lauragabrielaneaga/P1/P1_2021_433C_Neaga_Laura-Gabriela_SERS_N16_OrCAD/schema_bloc.jpg

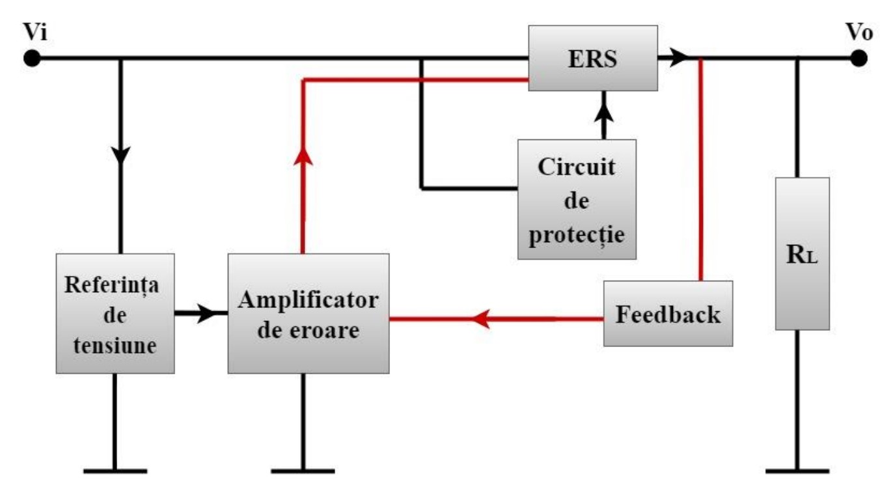
P1_2021_433C_Neaga_Laura-Gabriela_SERS_N16_OrCAD/schema_bloc.jpg
