lauragabrielaneaga/P1/P1_2021_433C_Neaga_Laura-Gabriela_SERS_N16_OrCAD/Schematics/Schema_transfer_OrCAD_PCB.jpg

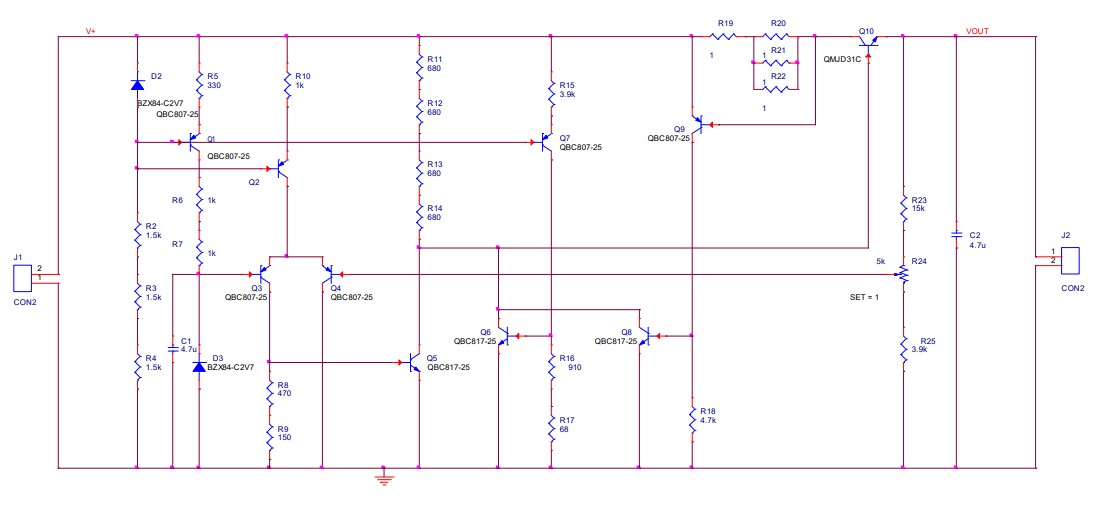
P1_2021_433C_Neaga_Laura-Gabriela_SERS_N16_OrCAD/Schematics/Schema_transfer_OrCAD_PCB.jpg
