lauragabrielaneaga/P1/P1_2021_433C_Neaga_Laura-Gabriela_SERS_N16_OrCAD/Simulations/Amplificarea in bucla deschisa a amplificatorului de eroare.jpg

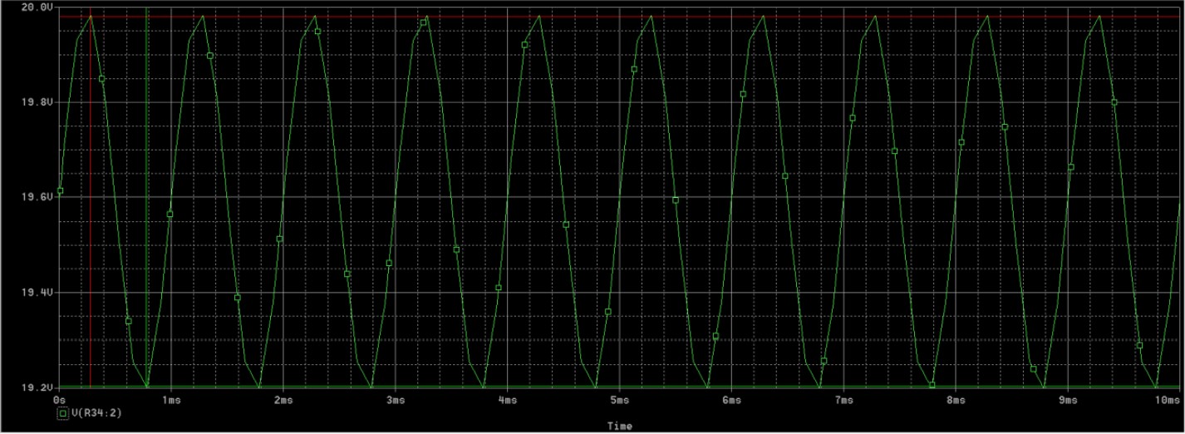
P1_2021_433C_Neaga_Laura-Gabriela_SERS_N16_OrCAD/Simulations/Amplificarea in bucla deschisa a amplificatorului de eroare.jpg
