lauragabrielaneaga/P1/P1_2021_433C_Neaga_Laura-Gabriela_SERS_N16_OrCAD/Simulations/Protectie termica_caz1.jpg

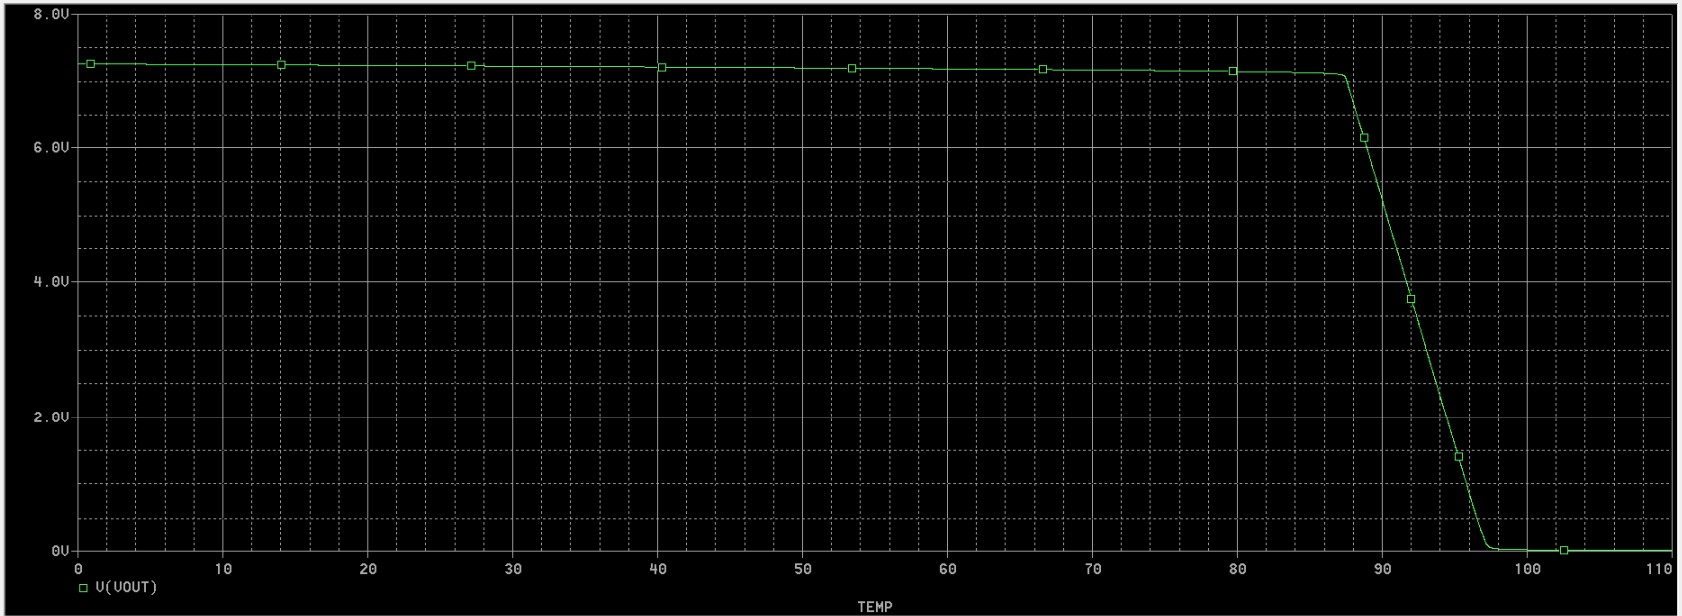
P1_2021_433C_Neaga_Laura-Gabriela_SERS_N16_OrCAD/Simulations/Protectie termica_caz1.jpg
