lauragabrielaneaga/P1/P1_2021_433C_Neaga_Laura-Gabriela_SERS_N16_OrCAD/Bill_of_Materials/BOM_Anexa_a1_Neaga_Laura-Gabriela.xlsx

Anexa a1 - Componente SMD disponibile pentru realizarea proiectului P1 - tehnologie SMT- AU 2021-2022
Nr. Crt. | Nume | Catalog | Cod distrib | Nume prod | Prod | Clasă | Qty fix | Qty final | Qty min | Descriere | Distribuitor | Pret (fara TVA) referinta/buc. TME România | Pret total pe reper (fara TVA) - propus | Pret total pe reper final (fara TVA) - necesar cerut de studenti | Pret total pe reper final (fara TVA)
1 | 0 ohm | (LINK) (http://www.tme.eu/ro/details/smd1206-0r/rezistente-smd-1206/royal-ohm/1206s4j0000t5e/) | 1206S4J0000T5E | 1206S4J0000T5E | SR PASSIVES | rezistor | 0 | 0 | 0 | Rezistor: thick film; SMD; 1206; 0Ω; 0,25W; ±5%; -55÷125°C | TME România | 0.03841 | 0 | 0 | 0 | indisponibil
2 | 0.47 | (LINK) (https://www.tme.eu/ro/details/0805s8j047kt5e/rezistente-smd-0805/royal-ohm/) | 0805S8J047KT5E | 0805S8J047KT5E | ROYAL OHM | rezistor | 0 | 0 | 0 | Rezistor: thick film; SMD; 0805; 470mΩ; 125mW; ±5%; -55÷125°C; 800ppm/°C | TME România | 0.02319 | 0 | 0 | 0
3 | 1 | (LINK) (https://www.tme.eu/ro/details/smd0805-1r/rezistente-smd-0805/royal-ohm/0805s8j010jt5e/) | SMD0805-1R | 0805S8J010JT5E | ROYAL OHM | rezistor | 0 | 0 | 4 | Rezistor: thick film; SMD; 0805; 1Ω; 0,125W; ±5%; -55÷125°C | TME România | 0.01624 | 0 | 0.06496
4 | 4.7 | (LINK) (https://www.tme.eu/ro/details/smd0805-4r7/rezistente-smd-0805/royal-ohm/0805s8j047jt5e/) | SMD0805-4R7 | 0805S8J047JT5E | ROYAL OHM | rezistor | 0 | 0 | 0 | Rezistor: thick film; SMD; 0805; 4,7Ω; 0,125W; ±5%; -55÷125°C | TME România | 0.01624 | 0 | 0 | 0
5 | 10 | (LINK) (https://www.tme.eu/ro/details/smd0805-10r/rezistente-smd-0805/royal-ohm/0805s8j0100t5e/) | SMD0805-10R | 0805S8J0100T5E | ROYAL OHM | rezistor | 0 | 0 | 0 | Rezistor: thick film; SMD; 0805; 10Ω; 0,125W; ±5%; -55÷125°C | TME România | 0.01419 | 0 | 0 | 0
6 | 22 | (LINK) (https://www.tme.eu/ro/details/smd0805-22r-1%25/rezistente-smd-0805/royal-ohm/0805s8f220jt5e/) | SMD0805-22R-1% | 0805S8F220JT5E | ROYAL OHM | rezistor | 0 | 0 | 0 | Rezistor: thick film; SMD; 0805; 22Ω; 0,125W; ±1%; -55÷125°C | TME România | 0.01971 | 0 | 0 | 0
7 | 33 | (LINK) (https://www.tme.eu/ro/details/smd0805-33r/rezistente-smd-0805/royal-ohm/0805s8j0330t5e/) | SMD0805-33R | 0805S8J0330T5E | ROYAL OHM | rezistor | 0 | 0 | 0 | Rezistor: thick film; SMD; 0805; 33Ω; 0,125W; ±5%; -55÷125°C | TME România | 0.01624 | 0 | 0 | 0
8 | 51 | (LINK) (https://www.tme.eu/ro/details/0805s8j0510t5e/rezistente-smd-0805/royal-ohm/) | 0805S8J0510T5E | 0805S8J0510T5E | ROYAL OHM | rezistor | 0 | 0 | 0 | Rezistor: thick film; SMD; 0805; 51Ω; 0,125W; ±5%; -55÷155°C; 200ppm/°C | TME România | 0.00515 | 0 | 0 | 0
9 | 68 | (LINK) (https://www.tme.eu/ro/details/smd0805-68r/rezistente-smd-0805/royal-ohm/0805s8j0680t5e/) | SMD0805-68R | 0805S8J0680T5E | ROYAL OHM | rezistor | 0 | 0 | 1 | Rezistor: thick film; SMD; 0805; 68Ω; 0,125W; ±5%; -55÷125°C | TME România | 0.01624 | 0 | 0.01624 | 0
10 | 82 | (LINK) (https://www.tme.eu/ro/details/smd0805-82r/rezistente-smd-0805/royal-ohm/0805s8j0820t5e/) | SMD0805-82R | 0805S8J0820T5E | ROYAL OHM | rezistor | 0 | 0 | 0 | Rezistor: thick film; SMD; 0805; 82Ω; 0,125W; ±5%; -55÷125°C | TME România | 0.01624 | 0 | 0 | 0
11 | 100 | (LINK) (https://www.tme.eu/ro/details/smd0805-100r/rezistente-smd-0805/royal-ohm/0805s8j0101t5e/) | SMD0805-100R | 0805S8J0101T5E | ROYAL OHM | rezistor | 0 | 0 | 0 | Rezistor: thick film; SMD; 0805; 100Ω; 0,125W; ±5%; -55÷125°C | TME România | 0.01092 | 0 | 0 | 0
12 | 150 | (LINK) (https://www.tme.eu/ro/details/smd0805-150r/rezistente-smd-0805/royal-ohm/0805s8j0151t5e/) | SMD0805-150R | 0805S8J0151T5E | ROYAL OHM | rezistor | 0 | 0 | 1 | Rezistor: thick film; SMD; 0805; 150Ω; 0,125W; ±5%; -55÷125°C | TME România | 0.01624 | 0 | 0.01624 | 0
13 | 220 | (LINK) (https://www.tme.eu/ro/details/smd0805-220r/rezistente-smd-0805/royal-ohm/0805s8j0221t5e/) | SMD0805-220R | 0805S8J0221T5E | ROYAL OHM | rezistor | 0 | 0 | 0 | Rezistor: thick film; SMD; 0805; 220Ω; 0,125W; ±5%; -55÷125°C | TME România | 0.01415 | 0 | 0 | 0
14 | 330 | (LINK) (https://www.tme.eu/ro/details/smd0805-330r/rezistente-smd-0805/royal-ohm/0805s8j0331t5e/) | SMD0805-330R | 0805S8J0331T5E | ROYAL OHM | rezistor | 0 | 0 | 1 | Rezistor: thick film; SMD; 0805; 330Ω; 0,125W; ±5%; -55÷125°C | TME România | 0.01624 | 0 | 0.01624 | 0
15 | 470 | (LINK) (https://www.tme.eu/ro/details/smd0805-470r/rezistente-smd-0805/royal-ohm/0805s8j0471t5e/) | SMD0805-470R | 0805S8J0471T5E | ROYAL OHM | rezistor | 0 | 0 | 1 | Rezistor: thick film; SMD; 0805; 470Ω; 0,125W; ±5%; -55÷125°C | TME România | 0.01415 | 0 | 0.01415 | 0
16 | 510 | (LINK) (https://www.tme.eu/ro/details/smd0805-510r/rezistente-smd-0805/royal-ohm/0805s8j0511t5e/) | SMD0805-510R | 0805S8J0511T5E | ROYAL OHM | rezistor | 0 | 0 | 0 | Rezistor: thick film; SMD; 0805; 510Ω; 0,125W; ±5%; -55÷125°C | TME România | 0.01771 | 0 | 0 | 0
17 | 680 | (LINK) (https://www.tme.eu/ro/details/smd0805-680r/rezistente-smd-0805/royal-ohm/0805s8j0681t5e/) | SMD0805-680R | 0805S8J0681T5E | ROYAL OHM | rezistor | 0 | 0 | 4 | Rezistor: thick film; SMD; 0805; 680Ω; 0,125W; ±5%; -55÷125°C | TME România | 0.01624 | 0 | 0.06496 | 0
18 | 820 | (LINK) (https://www.tme.eu/ro/details/smd0805-820r/rezistente-smd-0805/royal-ohm/0805s8j0821t5e/) | SMD0805-820R | 0805S8J0821T5E | ROYAL OHM | rezistor | 0 | 0 | 0 | Rezistor: thick film; SMD; 0805; 820Ω; 0,125W; ±5%; -55÷125°C | TME România | 0.01624 | 0 | 0 | 0
19 | 910 | (LINK) (https://www.tme.eu/ro/details/smd0805-910r/rezistente-smd-0805/royal-ohm/0805s8j0911t5e/) | SMD0805-910R | 0805S8J0911T5E | ROYAL OHM | rezistor | 0 | 0 | 1 | Rezistor: thick film; SMD; 0805; 910Ω; 0,125W; ±5%; -55÷125°C | TME România | 0.01624 | 0 | 0.01624 | 0
20 | 1k | (LINK) (https://www.tme.eu/ro/details/smd0805-1k/rezistente-smd-0805/royal-ohm/0805s8j0102t5e/) | SMD0805-1K | 0805S8J0102T5E | ROYAL OHM | rezistor | 0 | 0 | 3 | Rezistor: thick film; SMD; 0805; 1kΩ; 0,125W; ±5%; -55÷125°C | TME România | 0.01301 | 0 | 0.03903 | 0
21 | 1.5k | (LINK) (https://www.tme.eu/ro/details/smd0805-1k5/rezistente-smd-0805/royal-ohm/0805s8j0152t5e/) | SMD0805-1K5 | 0805S8J0152T5E | ROYAL OHM | rezistor | 0 | 0 | 3 | Rezistor: thick film; SMD; 0805; 1,5kΩ; 0,125W; ±5%; -55÷125°C | TME România | 0.01624 | 0 | 0.04872 | 0
22 | 1.8k | (LINK) (https://www.tme.eu/ro/details/smd0805-1k8/rezistente-smd-0805/royal-ohm/0805s8j0182t5e/) | SMD0805-1K8 | 0805S8J0182T5E | ROYAL OHM | rezistor | 0 | 0 | 0 | Rezistor: thick film; SMD; 0805; 1,8kΩ; 0,125W; ±5%; -55÷125°C | TME România | 0.01624 | 0 | 0 | 0
23 | 2k | (LINK) (https://www.tme.eu/ro/details/smd0805-2k/rezistente-smd-0805/royal-ohm/0805s8j0202t5e/) | SMD0805-2K | 0805S8J0202T5E | ROYAL OHM | rezistor | 0 | 0 | 0 | Rezistor: thick film; SMD; 0805; 2kΩ; 0,125W; ±5%; -55÷125°C | TME România | 0.01624 | 0 | 0 | 0
24 | 2.2k | (LINK) (https://www.tme.eu/ro/details/smd0805-2k2/rezistente-smd-0805/royal-ohm/0805s8j0222t5e/) | SMD0805-2K2 | 0805S8J0222T5E | ROYAL OHM | rezistor | 0 | 0 | 0 | Rezistor: thick film; SMD; 0805; 2,2kΩ; 0,125W; ±5%; -55÷125°C | TME România | 0.01415 | 0 | 0 | 0
25 | 2.7k | (LINK) (https://www.tme.eu/ro/details/smd0805-2k7/rezistente-smd-0805/royal-ohm/0805s8j0272t5e/) | SMD0805-2K7 | 0805S8J0272T5E | ROYAL OHM | rezistor | 0 | 0 | 0 | Rezistor: thick film; SMD; 0805; 2,7kΩ; 0,125W; ±5%; -55÷125°C | TME România | 0.01624 | 0 | 0 | 0
26 | 3.3k | (LINK) (https://www.tme.eu/ro/details/smd0805-3k3/rezistente-smd-0805/royal-ohm/0805s8j0332t5e/) | SMD0805-3K3 | 0805S8J0332T5E | ROYAL OHM | rezistor | 0 | 0 | 0 | Rezistor: thick film; SMD; 0805; 3,3kΩ; 0,125W; ±5%; -55÷125°C | TME România | 0.01624 | 0 | 0 | 0
27 | 3.9k | (LINK) (https://www.tme.eu/ro/details/smd0805-3k9/rezistente-smd-0805/royal-ohm/0805s8j0392t5e/) | SMD0805-3K9 | 0805S8J0392T5E | ROYAL OHM | rezistor | 0 | 0 | 2 | Rezistor: thick film; SMD; 0805; 3,9kΩ; 0,125W; ±5%; -55÷125°C | TME România | 0.01624 | 0 | 0.03248 | 0
28 | 4.7k | (LINK) (https://www.tme.eu/ro/details/smd0805-4k7/rezistente-smd-0805/royal-ohm/0805s8j0472t5e/) | SMD0805-4K7 | 0805S8J0472T5E | ROYAL OHM | rezistor | 0 | 0 | 1 | Rezistor: thick film; SMD; 0805; 4,7kΩ; 0,125W; ±5%; -55÷125°C | TME România | 0.01215 | 0 | 0.01215 | 0
29 | 5.6k | (LINK) (https://www.tme.eu/ro/details/smd0805-5k6/rezistente-smd-0805/royal-ohm/0805s8j0562t5e/) | SMD0805-5K6 | 0805S8J0562T5E | ROYAL OHM | rezistor | 0 | 0 | 0 | Rezistor: thick film; SMD; 0805; 5,6kΩ; 0,125W; ±5%; -55÷125°C | TME România | 0.01624 | 0 | 0 | 0
30 | 6.8k | (LINK) (https://www.tme.eu/ro/details/smd0805-6k8-1%25/rezistente-smd-0805/royal-ohm/0805s8f6801t5e/) | SMD0805-6K8-1% | 0805S8F6801T5E | ROYAL OHM | rezistor | 0 | 0 | 0 | Rezistor: thick film; SMD; 0805; 6,8kΩ; 0,125W; ±1%; -55÷125°C | TME România | 0.01971 | 0 | 0 | 0
31 | 8.2k | (LINK) (https://www.tme.eu/ro/details/smd0805-8k2/rezistente-smd-0805/royal-ohm/0805s8j0822t5e/) | SMD0805-8K2 | 0805S8J0822T5E | ROYAL OHM | rezistor | 0 | 0 | 0 | Rezistor: thick film; SMD; 0805; 8,2kΩ; 0,125W; ±5%; -55÷125°C | TME România | 0.01624 | 0 | 0 | 0
32 | 9.1k | (LINK) (https://www.tme.eu/ro/details/smd0805-9k1/rezistente-smd-0805/royal-ohm/0805s8j0912t5e/) | SMD0805-9K1 | 0805S8J0912T5E | ROYAL OHM | rezistor | 0 | 0 | 0 | Rezistor: thick film; SMD; 0805; 9,1kΩ; 0,125W; ±5%; -55÷125°C | TME România | 0.01624 | 0 | 0 | 0
33 | 10k | (LINK) (https://www.tme.eu/ro/details/smd0805-10k/rezistente-smd-0805/royal-ohm/0805s8j0103t5e/) | SMD0805-10K | 0805S8J0103T5E | ROYAL OHM | rezistor | 0 | 0 | 0 | Rezistor: thick film; SMD; 0805; 10kΩ; 0,125W; ±5%; -55÷125°C | TME România | 0.00982 | 0 | 0 | 0
34 | 15k | (LINK) (https://www.tme.eu/ro/details/smd0805-15k/rezistente-smd-0805/royal-ohm/0805s8j0153t5e/) | SMD0805-15K | 0805S8J0153T5E | ROYAL OHM | rezistor | 0 | 0 | 1 | Rezistor: thick film; SMD; 0805; 15kΩ; 0,125W; ±5%; -55÷125°C | TME România | 0.01624 | 0 | 0.01624 | 0
35 | 22k | (LINK) (https://www.tme.eu/ro/details/smd0805-22k/rezistente-smd-0805/royal-ohm/0805s8j0223t5e/) | SMD0805-22K | 0805S8J0223T5E | ROYAL OHM | rezistor | 0 | 0 | 0 | Rezistor: thick film; SMD; 0805; 22kΩ; 0,125W; ±5%; -55÷125°C | TME România | 0.01415 | 0 | 0 | 0
36 | 47k | (LINK) (http://www.tme.eu/ro/details/smd0805-47k/rezistente-smd-0805/royal-ohm/0805s8j0473t5e/) | SMD0805-47K | 0805S8J0473T5E | ROYAL OHM | rezistor | 0 | 0 | 0 | Rezistor: thick film; SMD; 0805; 47kΩ; 0,125W; ±5%; -55÷125°C | TME România | 0.01223 | 0 | 0 | 0
37 | 68k | (LINK) (https://www.tme.eu/ro/details/smd0805-68k/rezistente-smd-0805/royal-ohm/0805s8j0683t5e/) | SMD0805-68K | 0805S8J0683T5E | ROYAL OHM | rezistor | 0 | 0 | 0 | Rezistor: thick film; SMD; 0805; 68kΩ; 0,125W; ±5%; -55÷125°C | TME România | 0.01624 | 0 | 0 | 0
38 | 100k | (LINK) (https://www.tme.eu/ro/details/smd0805-100k/rezistente-smd-0805/royal-ohm/0805s8j0104t5e/) | SMD0805-100K | 0805S8J0104T5E | ROYAL OHM | rezistor | 0 | 0 | 0 | Rezistor: thick film; SMD; 0805; 100kΩ; 0,125W; ±5%; -55÷125°C | TME România | 0.01411 | 0 | 0 | 0
39 | 150k | (LINK) (http://www.tme.eu/ro/details/smd0805-150k/rezistente-smd-0805/royal-ohm/0805s8j0154t5e/) | SMD0805-150K | 0805S8J0154T5E | ROYAL OHM | rezistor | 0 | 0 | 0 | Rezistor: thick film; SMD; 0805; 150kΩ; 0,125W; ±5%; -55÷125°C | TME România | 0.01624 | 0 | 0 | 0
40 | 180k | (LINK) (https://www.tme.eu/ro/details/smd0805-180k-1%25/rezistente-smd-0805/royal-ohm/0805s8f1803t5e/) | SMD0805-180K-1% | 0805S8F1803T5E | ROYAL OHM | rezistor | 0 | 0 | 0 | Rezistor: thick film; SMD; 0805; 180kΩ; 0,125W; ±1%; -55÷125°C | TME România | 0.01971 | 0 | 0 | 0
41 | 220k | (LINK) (https://www.tme.eu/ro/details/smd0805-220k/rezistente-smd-0805/royal-ohm/0805s8j0224t5e/) | SMD0805-220K | 0805S8J0224T5E | ROYAL OHM | rezistor | 0 | 0 | 0 | Rezistor: thick film; SMD; 0805; 220kΩ; 0,125W; ±5%; -55÷125°C | TME România | 0.01415 | 0 | 0 | 0
42 | 330k | (LINK) (https://www.tme.eu/ro/details/smd0805-330k-1%25/rezistente-smd-0805/royal-ohm/0805s8f3303t5e/) | SMD0805-330K-1% | 0805S8F3303T5E | ROYAL OHM | rezistor | 0 | 0 | 0 | Rezistor: thick film; SMD; 0805; 330kΩ; 0,125W; ±1%; -55÷125°C | TME România | 0.01971 | 0 | 0 | 0
43 | 390k | (LINK) (https://www.tme.eu/ro/details/smd0805-390k/rezistente-smd-0805/royal-ohm/0805s8j0394t5e/) | SMD0805-390K | 0805S8J0394T5E | ROYAL OHM | rezistor | 0 | 0 | 0 | Rezistor: thick film; SMD; 0805; 390kΩ; 0,125W; ±5%; -55÷125°C | TME România | 0.01624 | 0 | 0 | 0
44 | 510k | (LINK) (https://www.tme.eu/ro/details/smd0805-510k/rezistente-smd-0805/royal-ohm/0805s8j0514t5e/) | SMD0805-510K | 0805S8J0514T5E | ROYAL OHM | rezistor | 0 | 0 | 0 | Rezistor: thick film; SMD; 0805; 510kΩ; 0,125W; ±5%; -55÷125°C | TME România | 0.01624 | 0 | 0 | 0
45 | 1M | (LINK) (https://www.tme.eu/ro/details/smd0805-1m-1%25/rezistente-smd-0805/royal-ohm/0805s8f1004t5e/) | SMD0805-1M-1% | 0805S8F1004T5E | ROYAL OHM | rezistor | 0 | 0 | 0 | Rezistor: thick film; SMD; 0805; 1MΩ; 0,125W; ±1%; -55÷125°C | TME România | 0.01971 | 0 | 0 | 0
46 | 2M | (LINK) (http://www.tme.eu/ro/details/smd0805-2m/rezistente-smd-0805/royal-ohm/0805waj-2m-t5e/) | SMD0805-2M | 0805S8J0205T5E | ROYAL OHM | rezistor | 0 | 0 | 0 | Rezistor: thick film; SMD; 0805; 2MΩ; 0,125W; ±5%; -55÷125°C | TME România | 0.01624 | 0 | 0 | 0
47 | 5,1M | (LINK) (http://www.tme.eu/ro/details/smd0805-5m1/rezistente-smd-0805/royal-ohm/0805s8j0515t5e/) | SMD0805-5M1 | 0805S8J0515T5E | ROYAL OHM | rezistor | 0 | 0 | 0 | Rezistor: thick film; SMD; 0805; 5,1MΩ; 0,125W; ±5%; -55÷125°C | TME România | 0.01624 | 0 | 0 | 0
48 | 10M | (LINK) (https://www.tme.eu/ro/details/smd0805-10m/rezistente-smd-0805/royal-ohm/0805s8j0106t5e/) | SMD0805-10M | 0805S8J0106T5E | ROYAL OHM | rezistor | 0 | 0 | 0 | Rezistor: thick film; SMD; 0805; 10MΩ; 0,125W; ±5%; -55÷125°C | TME România | 0.01624 | 0 | 0 | 0
49 | 100ohm | (LINK) (https://www.tme.eu/ro/details/ts53yl100r/trimere-smd-cu-o-singura-tura/vishay/ts53yl101mr10/) | TS53YL100R | TS53YL101MR10 | VISHAY | potențiometru | 0 | 0 | 0 | Potenţiometru: de montare; singură tură; 100Ω; 250mW; SMD; ±20%; 100ppm/°C | TME România | 3.25 | 0 | 0 | 0
50 | 500ohm | (LINK) (https://www.tme.eu/ro/details/ts53yl500r/trimere-smd-cu-o-singura-tura/vishay/ts53yl501mr10/) | TS53YL500R | TS53YL501MR10 | VISHAY | potențiometru | 0 | 0 | 0 | Potenţiometru: de montare; singură tură; 500Ω; 250mW; SMD; ±20%; 100ppm/°C | TME România | 2.57 | 0 | 0 | 0
51 | 2k | (LINK) (https://www.tme.eu/ro/details/3314g-1-202e/trimere-smd-cu-o-singura-tura/bourns/) | 3314G-1-202E | 3314G-1-202E | BOURNS | potențiometru | 0 | 0 | 0 | Potenţiometru: de montare; singură tură,orizontal; 2kΩ; 250mW; SMD; ±20%, 100ppm/°C | TME România | 3.59 | 0 | 0 | 0
52 | 5k | (LINK) (https://www.tme.eu/ro/details/ts53yl5k/trimere-smd-cu-o-singura-tura/vishay/ts53yl502mr10/) | TS53YL5K | TS53YL502MR10 | VISHAY | potențiometru | 0 | 0 | 1 | Potenţiometru: de montare; singură tură; 5kΩ; 250mW; SMD; ±20%; 100ppm/°C | TME România | 2.62 | 0 | 2.62 | 0
53 | 10k | (LINK) (https://www.tme.eu/ro/details/ts53yl10k/trimere-smd-cu-o-singura-tura/vishay/ts53yl103mr10/) | TS53YL10K | TS53YL103MR10 | VISHAY | potențiometru | 0 | 0 | 0 | Potenţiometru: de montare; singură tură; 10kΩ; 250mW; SMD; ±20%; 100ppm/°C | TME România | 2.57 | 0 | 0 | 0
54 | 50k | (LINK) (https://www.tme.eu/ro/details/ts53yl50k/trimere-smd-cu-o-singura-tura/vishay/ts53yl503mr10/) | TS53YL50K | TS53YL503MR10 | VISHAY | potențiometru | 0 | 0 | 0 | Potenţiometru: de montare; singură tură; 50kΩ; 250mW; SMD; ±20%; 100ppm/°C | TME România | 2.57 | 0 | 0 | 0
55 | 100k | (LINK) (http://www.tme.eu/ro/details/ts53yl100k/trimere-smd-cu-o-singura-tura/vishay/ts53yl104mr10/) | TS53YL100K | TS53YL104MR10 | VISHAY | potențiometru | 0 | 0 | 0 | Potenţiometru: de montare; singură tură; 100kΩ; 250mW; SMD; ±20%; 100ppm/°C | TME România | 3.16 | 0 | 0 | 0
56 | 500k | (LINK) (http://www.tme.eu/ro/details/3314g-1-504e/trimere-smd-cu-o-singura-tura/bourns/) | 3314G-1-504E | 3314G-1-504E | BOURNS | potențiometru | 0 | 0 | 0 | Potenţiometru: de montare; singură tură,orizontal; 500kΩ; 250mW; SMD; ±20%; 100ppm/°C | TME România | 3.5405 | 0 | 0 | 0
 | TOTAL - Componente pasive (rezistoare de valori fixe şi reglabile) |  |  |  |  |  |  |  |  | FARA TVA = | 0 | CU TVA= | 0 | 2.97765 | FARA TVA =
57 | 4.7pF | (LINK) (https://www.tme.eu/ro/details/cl21c4r7cbannnc/condensatoare-mlcc-smd-0805/samsung/) | CL21C4R7CBANNNC | CL21C4R7CBANNNC | SAMSUNG | condensator | 0 | 0 | 0 | ceramic; MLCC; 4,7pF; 50V; C0G; ±0,25pF; SMD; 0805 | TME România | 0.05245 | 0 | 0 | 0
58 | 10pF | (LINK) (https://www.tme.eu/ro/details/cl21c100jbannnc/condensatoare-mlcc-smd-0805/samsung/) | CL21C100JBANNNC | CL21C100JBANNNC | SAMSUNG | condensator | 0 | 0 | 0 | ceramic; MLCC; 10pF; 50V; C0G; ±5%; SMD; 0805 | TME România | 0.03414 | 0 | 0 | 0
59 | 47pF | (LINK) (http://www.tme.eu/ro/details/cl21c470jbannnc/condensatoare-mlcc-smd-0805/samsung/) | CL21C470JBANNNC | CL21C470JBANNNC | SAMSUNG | condensator | 0 | 0 | 0 | Condensator: ceramic; MLCC; 47pF; 50V; C0G; ±5%; SMD; 0805; -55÷125°C | TME România | 0.03788 | 0 | 0 | 0
60 | 100pF | (LINK) (http://www.tme.eu/ro/details/cl21c101jbannnc/condensatoare-mlcc-smd-0805/samsung/) | CL21C101JBANNNC | CL21C101JBANNNC | SAMSUNG | condensator | 0 | 0 | 0 | Condensator: ceramic; MLCC; 100pF; 50V; C0G; ±5%; SMD; 0805 | TME România | 0.03541 | 0 | 0 | 0
61 | 470pF | (LINK) (https://www.tme.eu/ro/details/cl21c471jbannnc/condensatoare-mlcc-smd-0805/samsung/) | CL21C471JBANNNC | CL21C471JBANNNC | SAMSUNG | condensator | 0 | 0 | 0 | Condensator: ceramic; MLCC; 470pF; 50V; C0G; ±5%; SMD; 0805 | TME România | 0.04007 | 0 | 0 | 0
62 | 1nF | (LINK) (https://www.tme.eu/ro/details/cl21c102jbcnnnc/condensatoare-mlcc-smd-0805/samsung/) | CL21C102JBCNNNC | CL21C102JBCNNNC | SAMSUNG | condensator | 0 | 0 | 0 | Condensator: ceramic; MLCC; 1nF; 50V; C0G; ±5%; SMD; 0805 | TME România | 0.05051 | 0 | 0 | 0
63 | 2.2nF | (LINK) (https://www.tme.eu/ro/details/cl21b222kbannnc/condensatoare-mlcc-smd-0805/samsung/) | CL21B222KBANNNC | CL21B222KBANNNC | SAMSUNG | condensator | 0 | 0 | 0 | Condensator: ceramic; MLCC; 2,2nF; 50V; X7R; ±10%; SMD; 0805 | TME România | 0.03215 | 0 | 0 | 0
64 | 4.7nF | (LINK) (https://www.tme.eu/ro/details/cl21b472kbannnc/condensatoare-mlcc-smd-0805/samsung/) | CL21B472KBANNNC | CL21B472KBANNNC | SAMSUNG | condensator | 0 | 0 | 0 | Condensator: ceramic; MLCC; 4,7nF; 50V; X7R; ±10%; SMD; 0805 | TME România | 0.0373 | 0 | 0 | 0
65 | 5.6nF | (LINK) (https://www.tme.eu/ro/details/cl21b562kbannnc/condensatoare-mlcc-smd-0805/samsung/) | CL21B562KBANNNC | CL21B562KBANNNC | SAMSUNG | condensator | 0 | 0 | 0 | Condensator: ceramic; MLCC; 5,6nF; 50V; X7R; ±10%; SMD; 0805 | TME România | 0.35551 | 0 | 0 | 0
66 | 10nF | (LINK) (https://www.tme.eu/ro/details/cl21b103kbannnc/condensatoare-mlcc-smd-0805/samsung/) | CL21B103KBANNNC | CL21B103KBANNNC | SAMSUNG | condensator | 0 | 0 | 0 | Condensator: ceramic; MLCC; 10nF; 50V; X7R; ±10%; SMD; 0805 | TME România | 0.04211 | 0 | 0 | 0
67 | 22nF | (LINK) (https://www.tme.eu/ro/details/cl21b223kbannnc/condensatoare-mlcc-smd-0805/samsung/) | CL21B223KBANNNC | CL21B223KBANNNC | SAMSUNG | condensator | 0 | 0 | 0 | Condensator: ceramic; MLCC; 22nF; 50V; X7R; ±10%; SMD; 0805 | TME România | 0.03322 | 0 | 0 | 0
68 | 33nF | (LINK) (https://www.tme.eu/ro/details/cl21b333jbannnc/condensatoare-mlcc-smd-0805/samsung/) | CL21B333JBANNNC | CL21B333JBANNNC | SAMSUNG | condensator | 0 | 0 | 0 | Condensator: ceramic; MLCC; 33nF; 50V; X7R; ±5%; SMD; 0805 | TME România | 0.06848 | 0 | 0 | 0
69 | 100nF | (LINK) (https://www.tme.eu/ro/details/cl21b104jbcnnnc/condensatoare-mlcc-smd-0805/samsung/) | CL21B104JBCNNNC | CL21B104JBCNNNC | SAMSUNG | condensator | 0 | 0 | 0 | Condensator: ceramic; MLCC; 100nF; 50V; X7R; ±5%; SMD; 0805 | TME România | 0.04492 | 0 | 0 | 0
70 | 220nF | (LINK) (https://www.tme.eu/ro/details/cl21b224kbfnnng/condensatoare-mlcc-smd-0805/samsung/) | CL21B224KBFNNNG | CL21B224KBFNNNG | SAMSUNG | condensator | 0 | 0 | 0 | Condensator: ceramic; MLCC; 220nF; 50V; X7R; ±10%; SMD; 0805 | TME România | 0.05051 | 0 | 0 | 0
71 | 330nF | (LINK) (https://www.tme.eu/ro/details/cl21b334kbfnnne/condensatoare-mlcc-smd-0805/samsung/) | CL21B334KBFNNNE | CL21B334KBFNNNE | SAMSUNG | condensator | 0 | 0 | 0 | Condensator: ceramic; MLCC; 330nF; 50V; X7R; ±10%; SMD; 0805 | TME România | 0.04167 | 0 | 0 | 0
72 | 470nF | (LINK) (https://www.tme.eu/ro/details/cl21b474kbfnnne/condensatoare-mlcc-smd-0805/samsung/) | CL21B474KBFNNNE | CL21B474KBFNNNE | SAMSUNG | condensator | 0 | 0 | 0 | Condensator: ceramic; MLCC; 470nF; 50V; X7R; ±10%; SMD; 0805 | TME România | 0.07236 | 0 | 0 | 0
73 | 1uF | (LINK) (https://www.tme.eu/ro/details/cl21b105kbfnnng/condensatoare-mlcc-smd-0805/samsung/) | CL21B105KBFNNNG | CL21B105KBFNNNG | SAMSUNG | condensator | 0 | 0 | 0 | Condensator: ceramic; MLCC; 1uF; 50V; X7R; ±10%; SMD; 0805 | TME România | 0.07188 | 0 | 0 | 0
74 | 2.2uF | (LINK) (https://www.tme.eu/ro/details/grm21br61h225ka73l/condensatoare-mlcc-smd-0805/murata/) | GRM21BR61H225KA73L | GRM21BR61H225KA73L | MURATA | condensator | 0 | 0 | 0 | Condensator: ceramic; MLCC; 2,2uF; 50V; X5R; ±10%; SMD; 0805 | TME România | 0.35065 | 0 | 0 | 0
75 | 4.7uF | (LINK) (https://www.tme.eu/ro/details/cl21a475kaqnnng/condensatoare-mlcc-smd-0805/samsung/) | CL21A475KAQNNNG | CL21A475KAQNNNG | SAMSUNG | condensator | 0 | 0 | 2 | Condensator: ceramic; MLCC; 4,7uF; 25V; X5R; ±10%; SMD; 0805 | TME România | 0.1185 | 0 | 0.237 | 0
76 | 10uF | (LINK) (https://www.tme.eu/ro/details/sc1h106m6l005vr/condensatoare-electrolitice-smd-85degc/samwha/) | SC1H106M6L005VR | SC1H106M6L005VR | SAMWHA | condensator | 0 | 0 | 0 | Condensator: electrolitic; SMD; 10uF; 50VDC; Ø6,3x5,3mm; ±20% | TME România | 0.13162 | 0 | 0 | 0
 | TOTAL - Componente pasive (condensatoare) |  |  |  |  |  |  |  |  | FARA TVA = | 0 | CU TVA= | 0 | 0.237 | FARA TVA =
77 | 4148 | (LINK) (https://www.tme.eu/ro/details/ts4148-ryg/diode-universale-smd/taiwan-semiconductor/ts4148-ryg/) | TS4148-RYG | TS4148 RYG | TAIWAN SEMICONDUCTOR | diodă pn | 0 | 0 | 0 | Diodă: comutaţie; SMD; 100V; 0,15A; 4ns; Ambalaj: rolă,bandă; 0805 | TME România | 0.0573 | 0 | 0 | 0
78 | LED | (LINK) (https://www.tme.eu/ro/details/of-smd2012g/diode-led-smd-colorate/optoflash/) | OF-SMD2012G | OF-SMD2012G | OPTOFLASH | LED | 0 | 0 | 0 | LED; SMD; 0805; verde; 50÷100mcd; 2x1,25x0,68mm; 120°; 1,8÷2V; 20mA | TME România | 0.1569 | 0 | 0 | 0
79 | 2.7V | (LINK) (http://www.tme.eu/ro/details/bzx84c2v7/diode-zener-smd/on-semiconductor/bzx84c2v7lt1g/) | BZX84C2V7 | BZX84-C2V7LT1G | ON Semiconductor | diodă Zener | 0 | 0 | 2 | Diodă Zener, SMD, SOT23, 2,7V, ±5%, 0.25W | TME România | 0.05974 | 0 | 0.11948 | 0
80 | 5.1V | (LINK) (https://www.tme.eu/ro/details/bzx84-c5v1.215/diode-zener-smd/nexperia/) | BZX84-C5V1.215 | BZX84-C5V1.215 | NEXPERIA | diodă Zener | 0 | 0 | 0 | Diodă: Zener; 0,25W; 5,1V; SMD; rolă,bandă; SOT23; Ifmax: 200mA | TME România | 0.06702 | 0 | 0 | 0
81 | 5.6V | (LINK) (https://www.tme.eu/ro/details/bzx84b5v6-dio/diode-zener-smd/diotec-semiconductor/bzx84b5v6/) | BZX84B5V6-DIO | BZX84B5V6 | DIOTEC SEMICONDUCTOR | diodă Zener | 0 | 0 | 0 | Diodă Zener, SMD, SOT23, 5,6V, ±5%, 0.3W | TME România | 0.0874 | 0 | 0 | 0
82 | 6.2V | (LINK) (https://www.tme.eu/ro/details/bzx84-c6v2.215/diode-zener-smd/nexperia/) | BZX84-C6V2.215 | BZX84-C6V2.215 | NEXPERIA | diodă Zener | 0 | 0 | 0 | Diodă Zener, SMD, SOT23, 6.2V, ±5%, 0.25W, Ifmax: 200mA | TME România | 0.06702 | 0 | 0 | 0
83 | 6.8V | (LINK) (https://www.tme.eu/ro/details/bzx84-c6v8.215/diode-zener-smd/nexperia/) | BZX84-C6V8.215 | BZX84-C6V8.215 | NEXPERIA | diodă Zener | 0 | 0 | 0 | Diodă Zener, SMD, SOT23, 6.8V, ±5%, 0.25W, Ifmax: 200mA | TME România | 0.06702 | 0 | 0 | 0
84 | 8.2V | (LINK) (https://www.tme.eu/ro/details/bzx84-c8v2.215/diode-zener-smd/nexperia/) | BZX84-C8V2.215 | BZX84-C8V2.215 | NEXPERIA | diodă Zener | 0 | 0 | 0 | Diodă Zener, SMD, SOT23, 8.2V, ±5%, 0.25W, Ifmax: 200mA | TME România | 0.06702 | 0 | 0 | 0
85 | 10V | (LINK) (https://www.tme.eu/ro/details/bzx84-c10.215/diode-zener-smd/nexperia/) | BZX84-C10.215 | BZX84-C10.215 | NEXPERIA | diodă Zener | 0 | 0 | 0 | Diodă Zener, SMD, SOT23, 10V, ±5%, 0.25W, Ifmax: 200mA | TME România | 0.06897 | 0 | 0 | 0
86 | PNP | (LINK) (http://www.tme.eu/ro/details/bc856b-dio/tranzistori-smd-pnp/diotec-semiconductor/bc856b/) | BC856B-DIO | BC856B | DIOTEC SEMICONDUCTOR | tranzistor bipolar | 0 | 0 | 0 | Tranzistor bipolar PNP, SMD, SOT23, 65V, 100mA, 250mW | TME România | 0.04225 | 0 | 0 | 0
87 | NPN | (LINK) (https://www.tme.eu/ro/details/bc846b-dio/tranzistori-smd-npn/diotec-semiconductor/bc846b/) | BC846B-DIO | BC846B | DIOTEC SEMICONDUCTOR | tranzistor bipolar | 0 | 0 | 0 | Tranzistor bipolar NPN, SMD, SOT23, 65V, 100mA, 250mW | TME România | 0.04157 | 0 | 0 | 0
88 | Nmos | (LINK) (http://www.tme.eu/ro/details/irfr120npbf/tranzistori-canal-n-smd/international-rectifier/) | IRFR120NPBF | IRFR120NPBF | International Rectifier | tranzistor NMOS | 0 | 0 | 0 | Tranzistor N-MOSFET, SMD, DPAK, 100V, 9.1A, 20V, 39W | TME România |  | 0 | 0 | 0
89 | N-JFET | (LINK) (http://www.tme.eu/ro/details/mmbfj309lt1g/tranzistori-canal-n-smd/on-semiconductor/) | MMBFJ309LT1G | MMBFJ309LT1G | ON Semiconductor | tranzistor NJFET | 0 | 0 | 0 | Tranzistor: N-JFET; unipolar; 25V; 30mA; 225mW; SMD SOT23; Igt: 10mA | TME România | 0.5974 | 0 | 0 | 0
90 | P-JFET | (LINK) (http://www.tme.eu/ro/details/mmbfj177lt1g/tranzistori-canal-p-smd/on-semiconductor/) | MMBFJ177LT1G | MMBFJ177LT1G | ON Semiconductor | tranzistor PJFET | 0 | 0 | 0 | Tranzistor: P-JFET; unipolar; 20mA; 30V; 225mW; SMD SOT23 | TME România | 0.6071 | 0 | 0 | 0
91 | NPN | (LINK) (http://www.tme.eu/ro/details/bc817-25-dio/tranzistori-smd-npn/diotec-semiconductor/bc817-25/) | BC817-25-DIO | BC817-25 | DIOTEC SEMICONDUCTOR | tranzistor bipolar | 0 | 0 | 3 | Tranzistor bipolar NPN, SMD, SOT23, 45V, 800mA | TME România | 0.04842 | 0 | 0.14526 | 0
92 | Conn2p |  | ZL301-40P | ZL301-40P |  | Sir pini, pas 2,54mm, SMD | 0 | 0 | 0 | Sir pini, pas 2,54mm, SMD, tip tata, bareta de 40 pini | TME România |  | 0 | 0 | 0
93 | PNP | (LINK) (http://www.tme.eu/ro/details/bc807-25-dio/tranzistori-smd-pnp/diotec-semiconductor/bc807-25/) | BC807-25-DIO | BC807-25 | DIOTEC SEMICONDUCTOR | tranzistor bipolar | 0 | 0 | 6 | Tranzistor bipolar PNP, SMD, SOT23, 45V, 800mA | TME România | 0.05634 | 0 | 0.33804 | 0
94 | NPN | (LINK) (http://www.tme.eu/ro/details/mjd31cg/tranzistori-smd-npn/on-semiconductor/) | MJD31CG | MJD31CG | ON Semiconductor | tranzistor bipolar | 0 | 0 | 1 | Tranzistor bipolar NPN, SMD, DPACK, 100V, 3A, 15W | TME România | 0.7771 | 0 | 0.7771 | 0
95 | Conn2p |  | ZL301-40P | ZL301-40P |  | Sir pini, pas 2,54mm, SMD | 0 | 0 | 2 | Sir pini, pas 2,54mm, SMD, tip tata, bareta de 40 pini | TME România | 2.73 | 0 | 5.46 | 0
96 | PNP | (LINK) (https://www.tme.eu/ro/details/mjd32ct4/tranzistori-smd-pnp/stmicroelectronics/) | MJD32CT4 | MJD32CT4 | STMICROELECTRONICS | tranzistor bipolar | 0 | 0 | 0 | Tranzistor bipolar PNP, SMD, DPACK, 100V, 3A, 15W | TME România | 0.5245 | 0 | 0 | 0
97 | Nmos | (LINK) (https://www.tme.eu/ro/details/irfr120ntrpbf/tranzistori-canal-n-smd/infineon-irf/) | IRFR120NTRPBF | IRFR120NTRPBF | INFINEON (IRF) | tranzistor NMOS | 0 | 0 | 0 | Tranzistor N-MOSFET, unipolar, SMD, DPAK, 100V, 9.1A, 39W | TME România | 1.0636 | 0 | 0 | 0
 | TOTAL - Componente semiconductoare (tranzistoare bipolare şi cu efect de câmp, diode, LED, etc.) |  |  |  |  |  |  |  |  | FARA TVA = | 0 | CU TVA= |  | 6.83988 | FARA TVA =
98 | Conn2p | (LINK) (http://www.tme.eu/ro/details/zl301-40p/pini-cu-benzi-si-soclu/ninigi/) | ZL301-40P | ZL301-40P | NINIGI | Sir pini, pas 2,54mm, SMD | 0 | 0 | 0 | Sir pini, pas 2,54mm, SMD, tip tata, bareta de 40 pini | TME România | 2.3027 | 0 | 0 | 0 | indisponibil
99 | FUSE | (LINK) (http://www.tme.eu/ro/details/3413.0116.11/sigurante-smd-1206-ultrarapide/schurter/) | 3413.0116.11 | 3413.0116.11 | SCHURTER | sigu-ranță | 0 | 0 | 0 | Siguranță sticlă, SMD, 1206, 1.25A, 48mΩ | TME România | 0 | 0 | 0 | 0 | indisponibil
 | Total - Conectică, sigurante fuzibile, etc. |  |  |  |  |  |  |  |  | FARA TVA = | 0 | CU TVA= | 0 | 0 | FARA TVA =
 | Total general |  |  |  |  |  |  |  |  | FARA TVA = | 0 | CU TVA= | 0 | 10.05453 | FARA TVA =
