lauragabrielaneaga/P1/P1_2021_433C_Neaga_Laura-Gabriela_SERS_N16_OrCAD/Bill_of_Materials/BOM.jpg

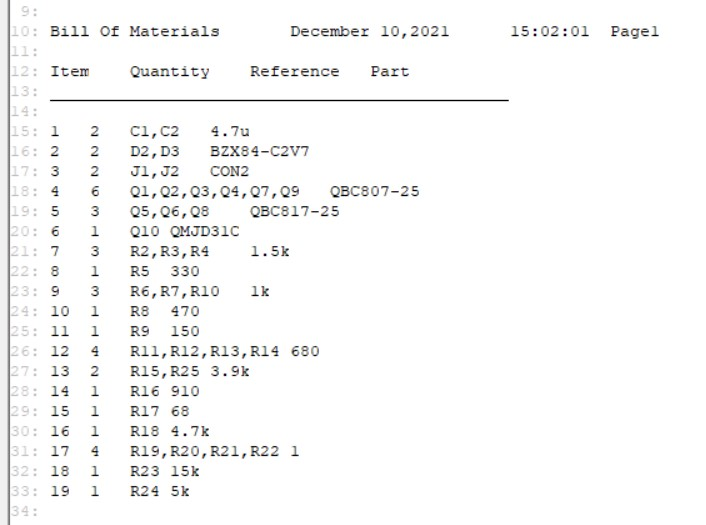
P1_2021_433C_Neaga_Laura-Gabriela_SERS_N16_OrCAD/Bill_of_Materials/BOM.jpg
