lauragabrielaneaga/P1/(list of files, drawings)

Other design files:
P1_2021_433C_Neaga_Laura-Gabriela_SERS_N16_OrCAD/Schematics/P1_Neaga_Laura-Gabriela_433C_schema_OrCAD/P1_NEAGA_LAURA-GABRIELA_433C.DSN
P1_2021_433C_Neaga_Laura-Gabriela_SERS_N16_OrCAD/Schematics/P1_Neaga_Laura-Gabriela_433C_schema_OrCAD/P1_Neaga_Laura-Gabriela_433C.opj
